AnshumanFauzdar/Oil-Dispenser/Images/1.JPG

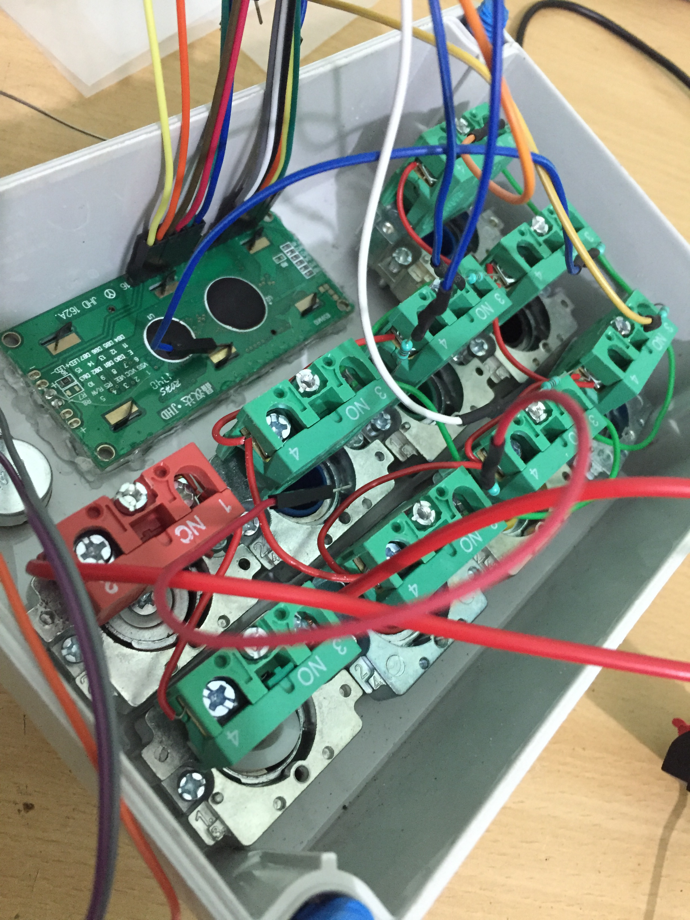
Images/1.JPG
