AnshumanFauzdar/Oil-Dispenser/Images/2.JPG

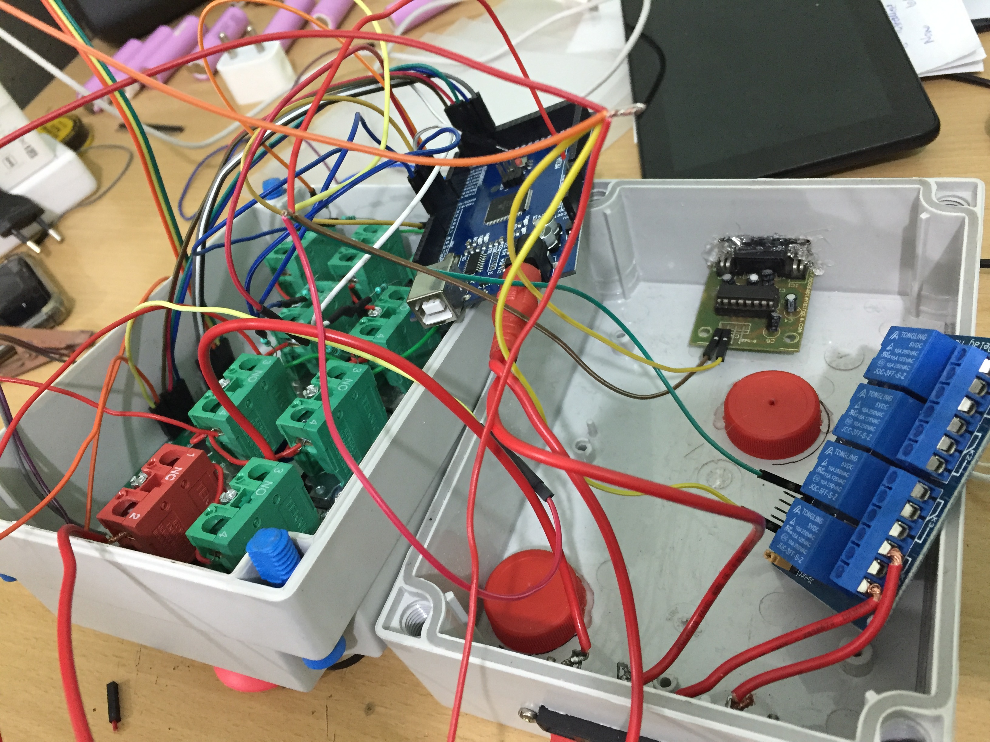
Images/2.JPG
