AnshumanFauzdar/Oil-Dispenser/Images/3.JPG

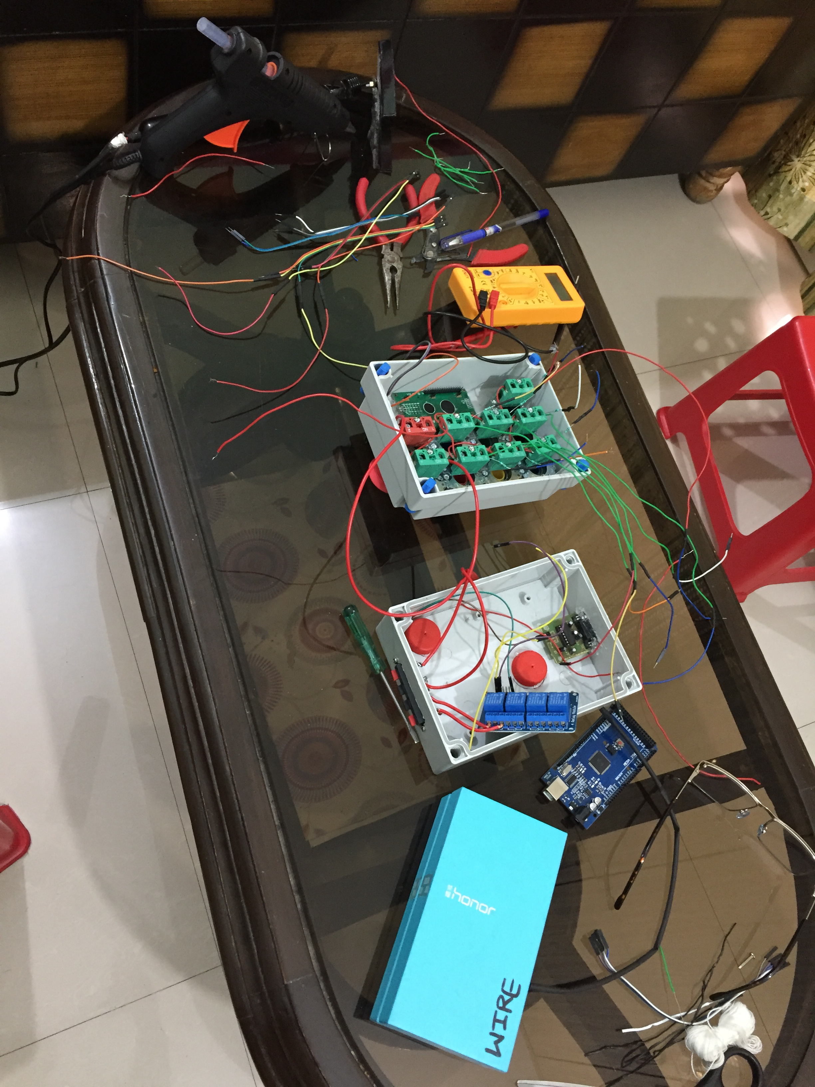
Images/3.JPG
