AnshumanFauzdar/Oil-Dispenser/Images/4.JPG

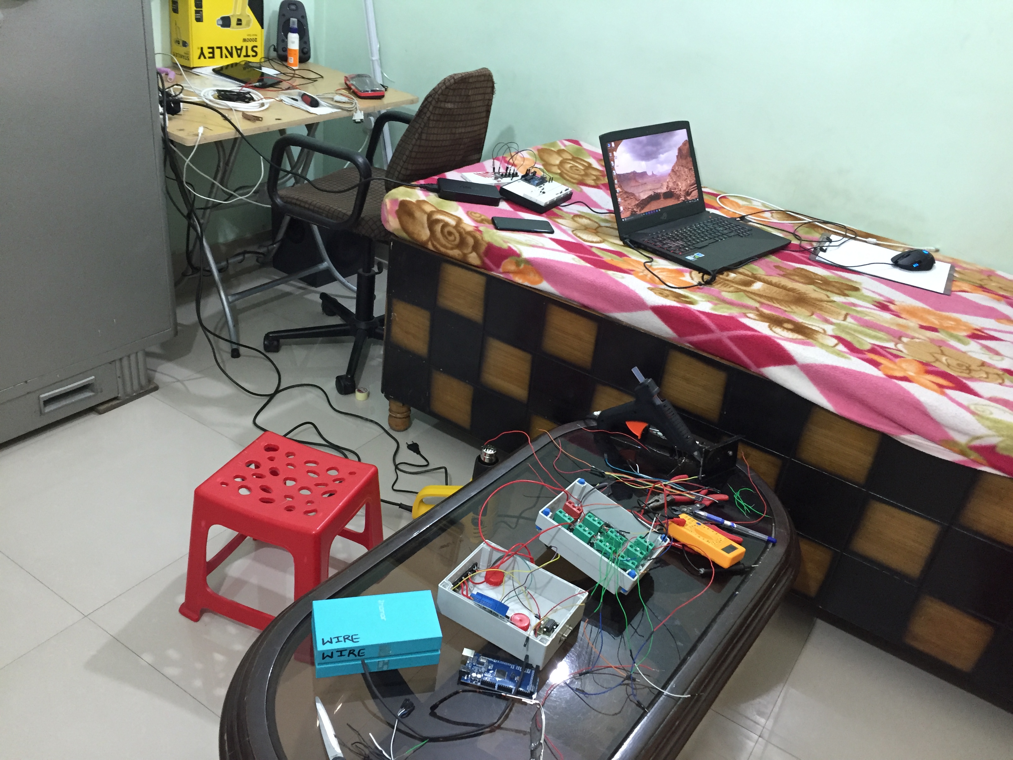
Images/4.JPG
