AnshumanFauzdar/Oil-Dispenser/Images/8.jpg

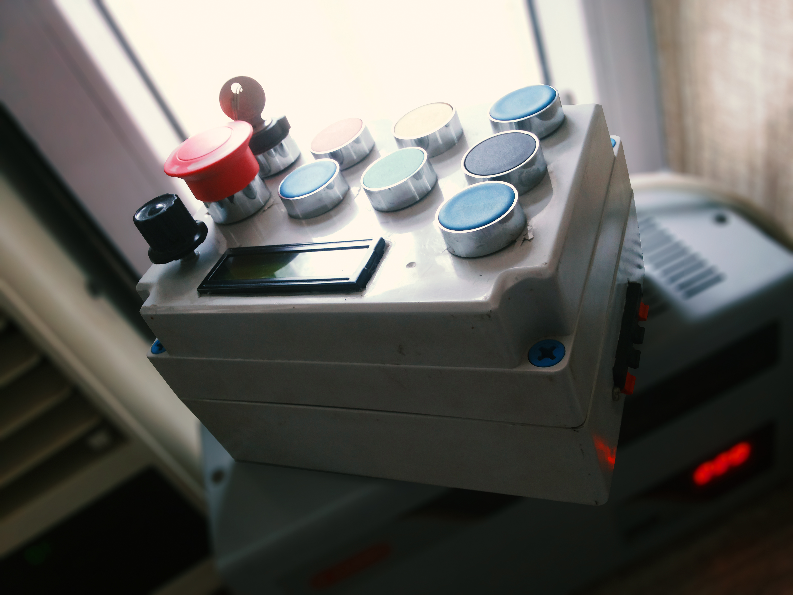
Images/8.jpg
