AnshumanFauzdar/Oil-Dispenser/Images/9.jpg

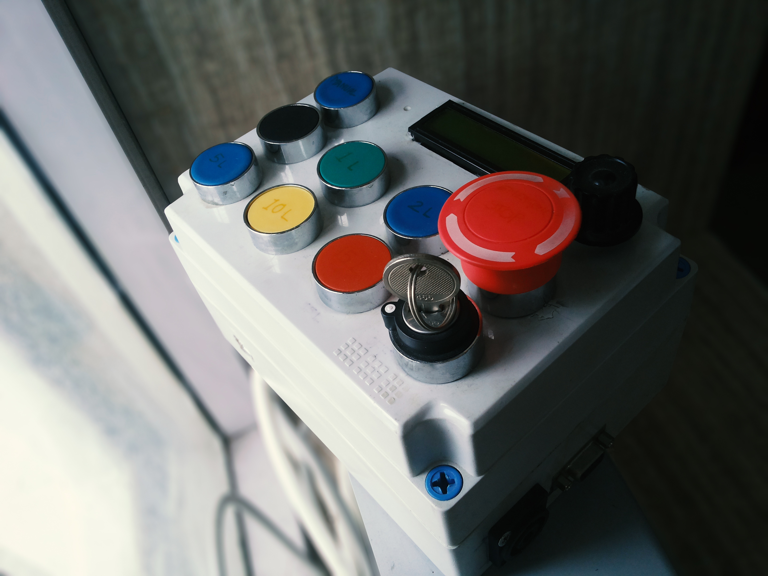
Images/9.jpg
