AnshumanFauzdar/Oil-Dispenser/Images/10.jpg

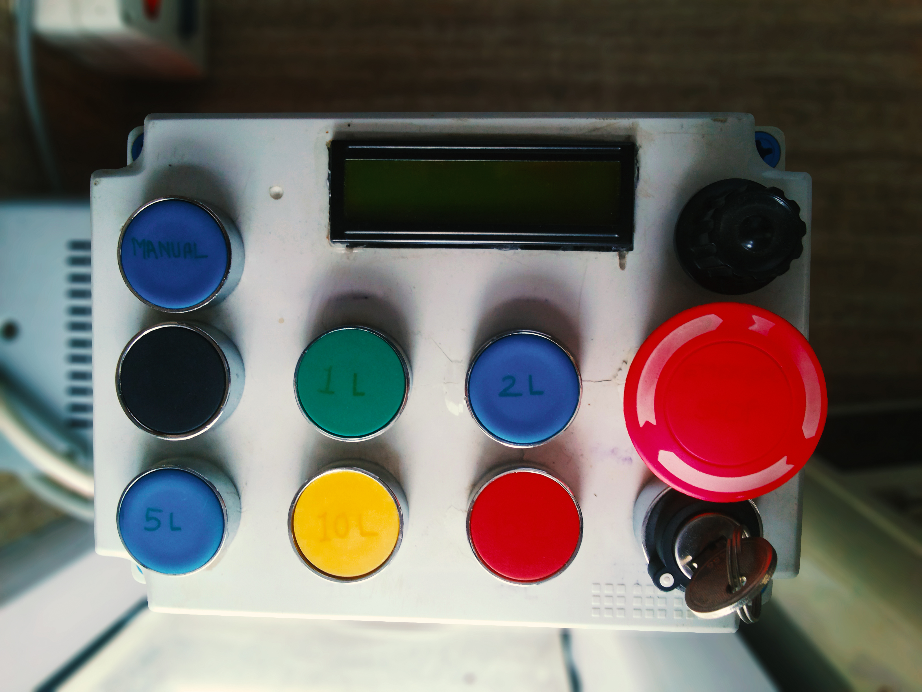
Images/10.jpg
