AnshumanFauzdar/Oil-Dispenser/Images/11.jpg

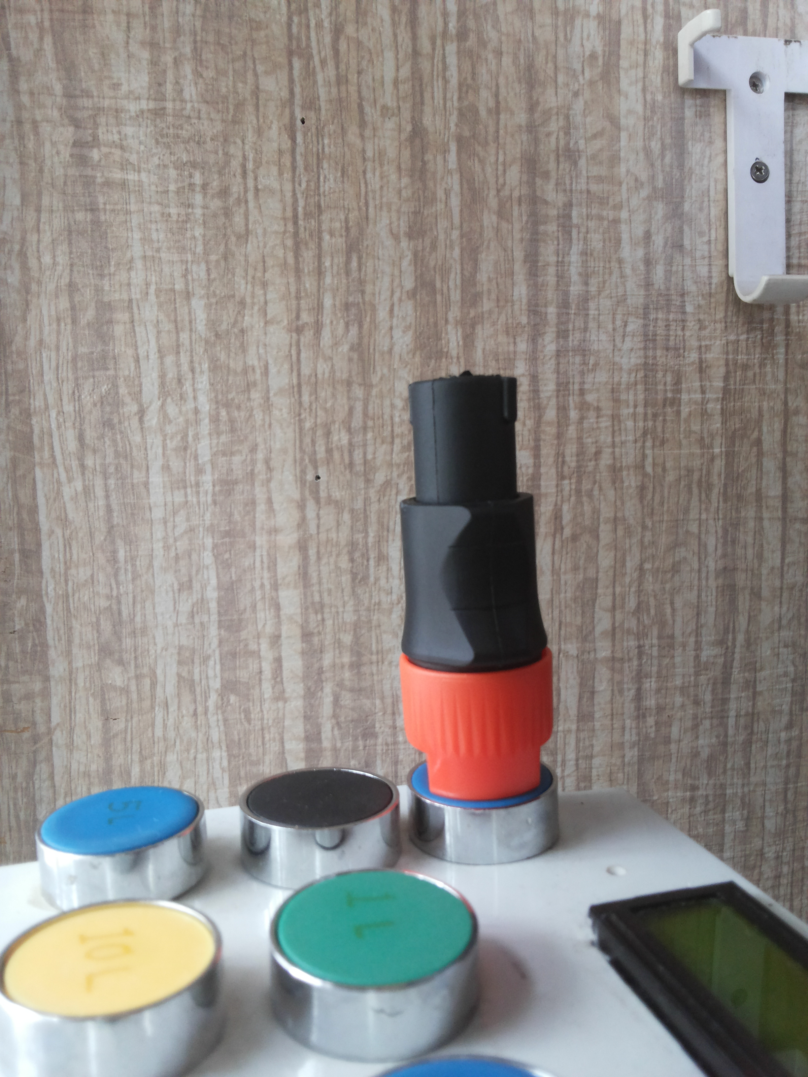
Images/11.jpg
