AnshumanFauzdar/Oil-Dispenser/FINAL.ino

#include <SoftwareSerial.h>
#include <Wire.h>
#include <hd44780.h>                       // main hd44780 header
#include <hd44780ioClass/hd44780_I2Cexp.h> // i2c expander i/o class header
#include<string.h>
hd44780_I2Cexp lcd; // declare lcd object: auto locate & auto config expander chip

const int LCD_COLS = 16;
const int LCD_ROWS = 2;

SoftwareSerial mySerial(10, 11); 

char myArray[12] = {"012345678AB"};

int relay = 9;
int pot2 = A2;
int button = 8;
int button2 = 7;
int button3 = 6;
int button4 = 5;
int button5 = 4;
int button6 = 3;
int button7 = 2;

double potvalue2 = 0;
int buttonvalue = 1;
int buttonvalue2 = 1;
int buttonvalue3 = 1;
int buttonvalue4 = 1;
int buttonvalue5 = 1;
int buttonvalue6 = 1;
int buttonvalue7 = 1;
double final_weight = 0;


char weight[7] = "";
double maxvalue = 1;
double maxvalue2 = 1;
char valid[50] = "false";
char valid2[50] = "false";
char valid3[50] = "false";
char valid4[50] = "false";
char valid5[50] = "false";
char valid6[50] = "false";
char valid7[50] = "false";

void setup()
{  
pinMode(relay, OUTPUT);
pinMode(button, INPUT); 
pinMode(button2, INPUT);
Serial.begin(9600);
mySerial.begin(9600);
digitalWrite(relay, 1);

  int status;

 
  status = lcd.begin(LCD_COLS, LCD_ROWS);
  if(status) // non zero status means it was unsuccesful
  {
    status = -status; // convert negative status value to positive number

    // begin() failed so blink error code using the onboard LED if possible
    hd44780::fatalError(status); // does not return
    
   
}

lcd.print("Welcome Vikas!");
    lcd.setCursor(0,1);
    lcd.print("Have a nice day");
    delay(5000);
    lcd.clear();
}

void loop()
{
 
  
  //Serial.println(analogRead(pot2));
  //delay(100);
    
  {
  while (mySerial.available() > 11)
  {
    myArray[0] = mySerial.read();

    //find the first charater, +
    if (myArray[0] == '+')
    {
      //read the remainding characters
      for (byte i = 1; i < 12; i++)
      {
        myArray[i] = mySerial.read();
        delay(1);
      }

      // Okay, myArray[1]thru myArray[7] has the data needed

      //Test print the characters
      for (byte i = 1; i < 8; i++)
      {
        Serial.print(myArray[i]);
        lcd.setCursor(0, 1);
        lcd.print(myArray);
      }
      
      Serial.println();
    } 

  } 

}
  
  
  
  buttonvalue = digitalRead(button);
  buttonvalue2 = digitalRead(button2);
  buttonvalue3 = digitalRead(button3);
  buttonvalue4 = digitalRead(button4);
  buttonvalue5 = digitalRead(button5);
  buttonvalue6 = digitalRead(button6);
  buttonvalue7 = digitalRead(button7);
  if(!strcmp(valid,"true"))
{
  buttonvalue=1;
}
  if(!strcmp(valid2,"true"))
{
  buttonvalue2=1;
}
  if(!strcmp(valid3, "true"))
  {
    buttonvalue3=1;
    }
if(!strcmp(valid4, "true"))
  {
    buttonvalue4=1;
    }

if(!strcmp(valid5, "true"))
{
  buttonvalue5=1;
  } 
if (!strcmp(valid6, "true"))
{
  buttonvalue6=1;
  } 
  if (!strcmp(valid7, "true"))
{
  buttonvalue7=1;
  }    
       
//FIRST BUTTON
    
  if(buttonvalue == 1)
  {
    lcd.clear();
    digitalWrite(relay, 0);
    strcpy(valid,"true");
    maxvalue = 000.390;
    lcd.setCursor(0,0);
    lcd.print("Vol INPUT:");
    lcd.print("500 ml");
    if(!strcmp(valid,"true"))
   {
    weight[0] = myArray[1];
    weight[1] = myArray[2];
    weight[2] = myArray[3];
    weight[3] = myArray[4];
    weight[4] = myArray[5];
    weight[5] = myArray[6];
    weight[6] = myArray[7];
    
    final_weight = strtod(weight,NULL);
    
   }
 
    if(final_weight>maxvalue)
    {
     digitalWrite(relay, 1); 
     strcpy(valid,"false");
    }
    }
    
    // SECOND SWITCH
    
  else if(buttonvalue2 == 1)
  {
    lcd.clear();
    digitalWrite(relay, 0);
    strcpy(valid2,"true");
    maxvalue = 00.910;
    lcd.setCursor(0,0);
    lcd.print("Vol INPUT:");
    lcd.print("1 L");
    if(!strcmp(valid2,"true"))
    {
      weight[0] = myArray[1];
    weight[1] = myArray[2];
    weight[2] = myArray[3];
    weight[3] = myArray[4];
    weight[4] = myArray[5];
    weight[5] = myArray[6];
    weight[6] = myArray[7];
    
    final_weight = strtod(weight,NULL);
    
      }
      if(final_weight>maxvalue)
      {
        digitalWrite(relay, 1);
        strcpy(valid2,"false");
        }
       }
       

// 3rd Button 
       
  else if(buttonvalue3 == 1)
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
   final_weight = strtod(weight,NULL);
   maxvalue2 = final_weight;
   lcd.setCursor(1,0);
    lcd.print("WT INPUT:");
    lcd.print(maxvalue2);
    lcd.print("L");
   }
 
  if(final_weight>maxvalue2)
    {
     digitalWrite(relay, 1); 
     strcpy(valid7,"false");
    }
    }
    */    
  }  
